Manas-arumalla/Steady-Stride_Self-balancing-robot/steady_stride_v0/Circuits/4] Console Arduino Nano IO-Cmmunications Circuit.pdf

# /pas]a Ground

## Analog

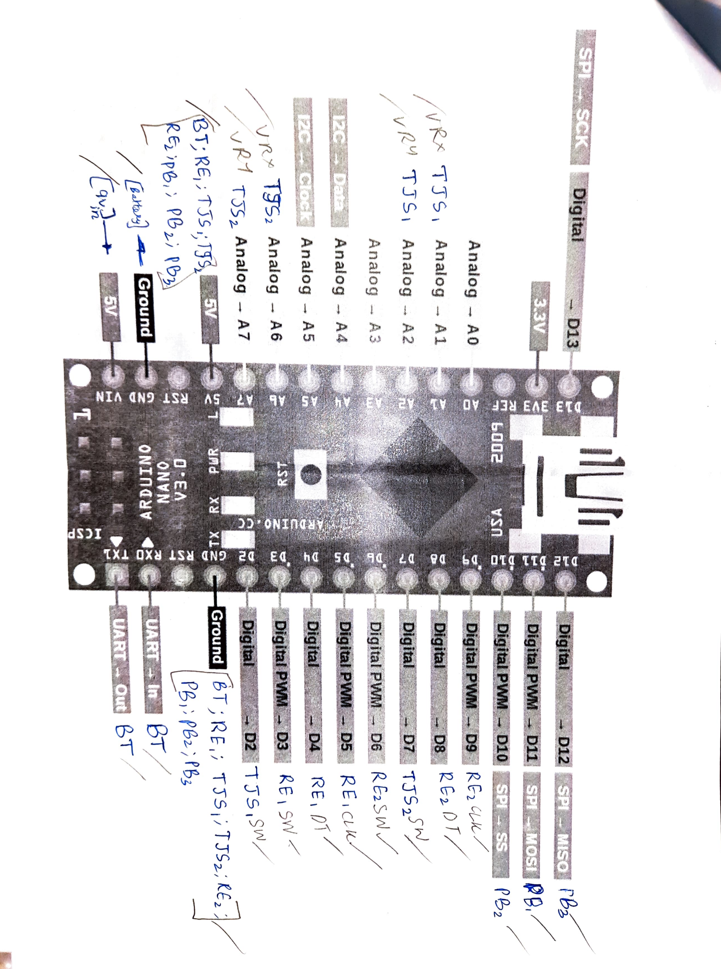
[picture p113: page 1]

ICSP

5V

ONINAN

UART Out BT

ONVN

TJS

### Analog

A7

UART

ARDUINO CC
TX1 RXO RST GND D2

### BT In

Vr

S2

A6

Digital Ground

BT;RE,;

### TSST

JS2,
KE,

### TJS,SW D2

Analog A5 -

A7 AL AS AeA A | AL AD REF 3V3 D13 VIN GND RST | 5V

Digital PWM

D3

## RE, SW

12C Dat

Digital

Analog A4 -

## D4 RE, D1

Digital PWM

Analog A3 -

D5

D3 D4 D5 DE D7 D8 D9 i0 D11 D12

REICLK

Digital PWM

### Analog T3ST /VK

Digital

A1

## RESW TJS,Sh D6 D7

Analog -

Digital

A0

D8

Digital PWM

D9 RE h

Digital PWM D10 Digital PWM D11

F

D13

SCKDigital

P,

Digital

SPI D12

SPIMOSI P

## MISO PB

Analog TJSI

A2
