Manas-arumalla/Steady-Stride_Self-balancing-robot/Gains Calcuation & SImulation/Output Graph.png

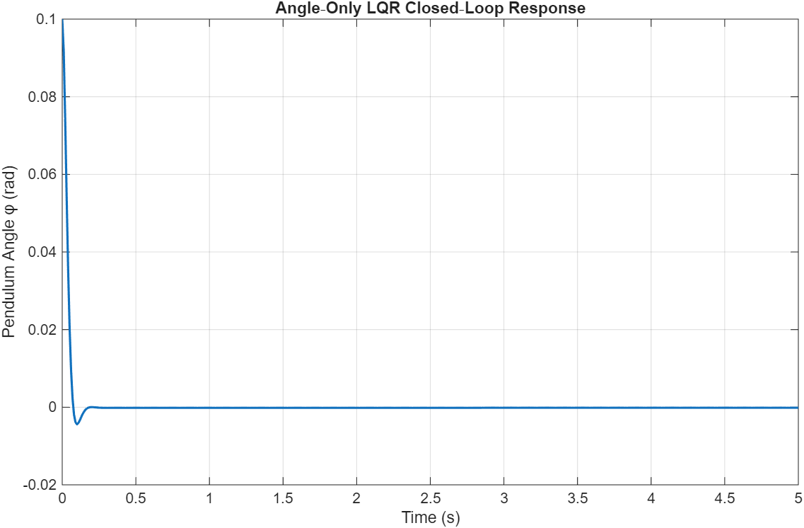
Gains Calcuation & SImulation/Output Graph.png
