Manas-arumalla/Steady-Stride_Self-balancing-robot/steady_stride_v0/Codes/src/libraries_dependencies/FastIMU/fast.png

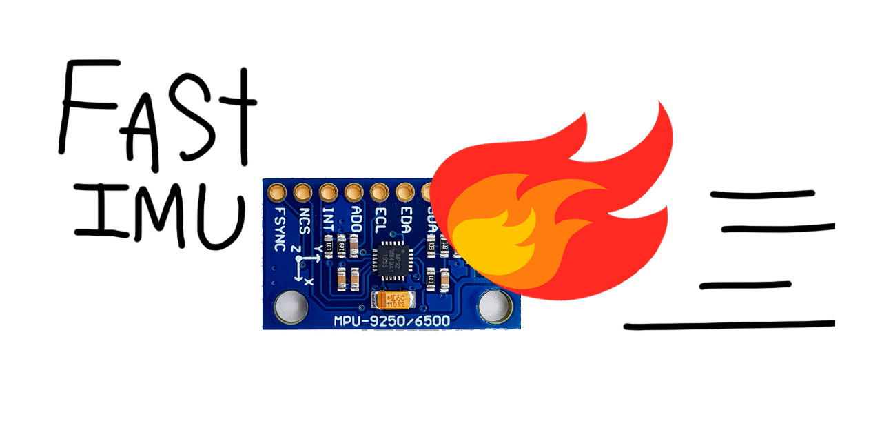
steady_stride_v0/Codes/src/libraries_dependencies/FastIMU/fast.png
