Manas-arumalla/Steady-Stride_Self-balancing-robot/steady_stride_v0/Codes/src/libraries_dependencies/invensense-imu-main/docs/MPU-9250-AXIS.png

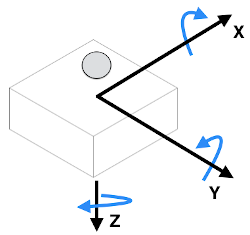
steady_stride_v0/Codes/src/libraries_dependencies/invensense-imu-main/docs/MPU-9250-AXIS.png
