Manas-arumalla/Steady-Stride_Self-balancing-robot/CAD/wheel_shaft_manas.stl

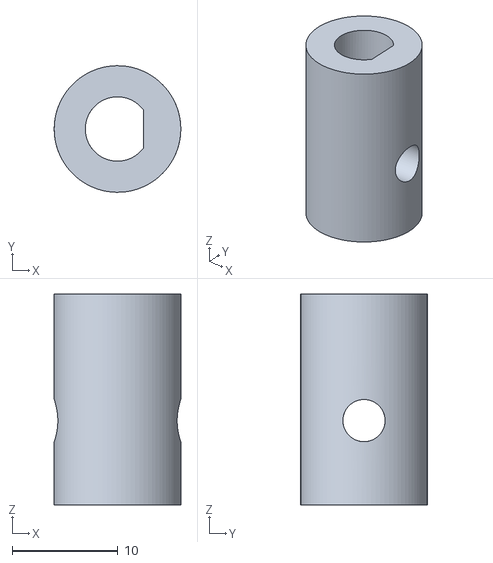
[picture p120: CAD file, 2025-09-05]
CAD/wheel_shaft_manas.stl
12.0 x 12.0 x 20.0
