Manas-arumalla/Steady-Stride_Self-balancing-robot/CAD/Motor_shaft.stl

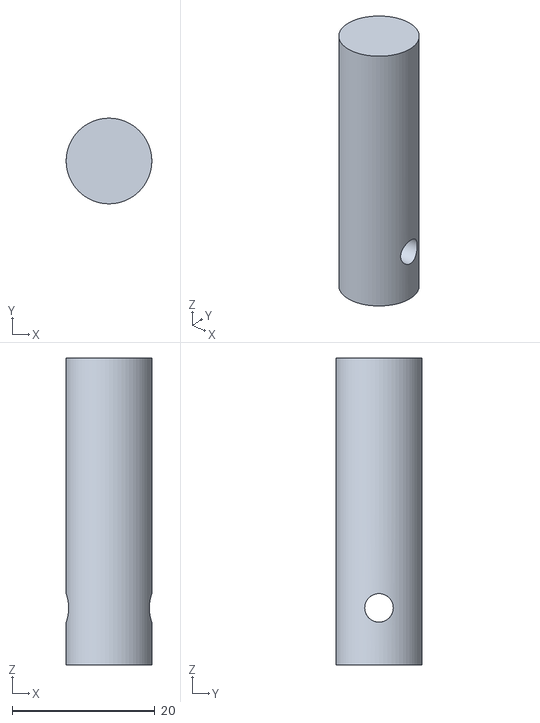
[picture p122: CAD file, 2025-09-05]
CAD/Motor_shaft.stl
12.0 x 12.0 x 43.0
