Manas-arumalla/Steady-Stride_Self-balancing-robot/steady_stride_v0/Codes/src/libraries_dependencies/MPU9250_WE/MPU9250__I2C_Arduino_Wiring.png

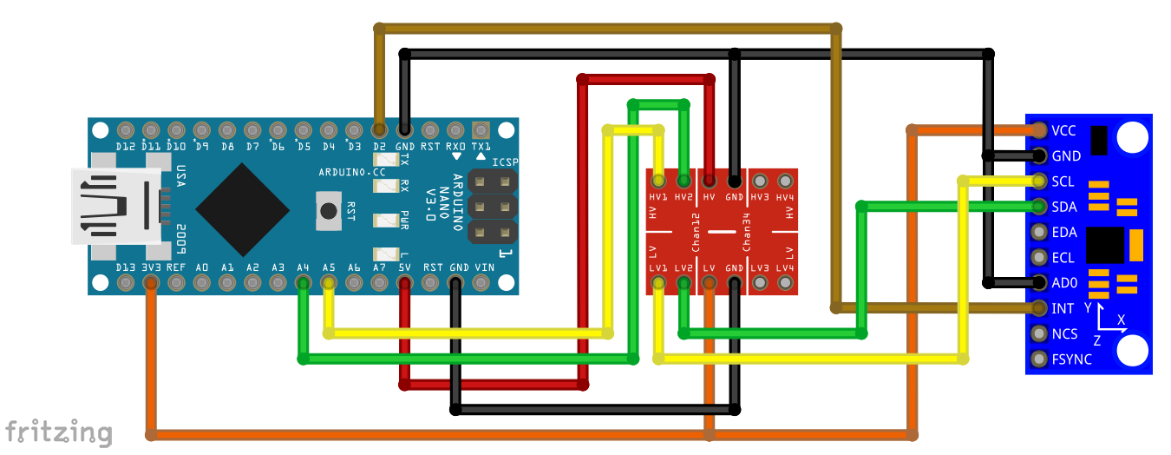
steady_stride_v0/Codes/src/libraries_dependencies/MPU9250_WE/MPU9250__I2C_Arduino_Wiring.png
