Manas-arumalla/Steady-Stride_Self-balancing-robot/Data/TEST1.csv

P:35.00 | I:0.20 | D:-0.40
TIME | gyroAngle
678 | -1.57
702 | -1.49
726 | -1.57
749 | -0.75
773 | -0.25
796 | -0.00
820 | 0.48
843 | 0.90
867 | 1.25
890 | 1.08
913 | 1.19
936 | 1.17
960 | 1.16
984 | 1.15
1007 | 1.21
1031 | 1.04
1054 | 0.99
1078 | 1.03
1101 | 1.11
1125 | 1.12
1148 | 1.13
1172 | 1.19
1196 | 1.22
1218 | 1.25
1242 | 1.33
1265 | 1.30
1289 | 1.39
1312 | 1.39
1336 | 1.51
1359 | 1.78
1383 | 1.86
1406 | 2.09
1430 | 1.99
1454 | 1.80
1477 | 1.11
1501 | 0.28
1524 | -0.46
1548 | -1.37
1571 | -1.99
1595 | -2.40
1618 | -2.03
1642 | -1.65
1666 | 0.01
1692 | 0.88
1715 | 1.88
1736 | 2.71
1759 | 2.59
1781 | 2.16
1804 | 2.10
1825 | 1.67
1848 | 1.20
1870 | 0.71
1893 | -0.09
1915 | -0.62
1937 | -1.22
1959 | -1.69
1982 | -1.92
2004 | -0.93
2027 | 0.08
2049 | 0.74
2071 | 1.38
2094 | 2.00
2116 | 2.71
2138 | 3.05
2160 | 2.96
2183 | 2.51
2204 | 1.38
2227 | 0.29
2249 | -1.03
2272 | -1.70
2294 | -2.83
2316 | -3.61
2338 | -2.84
2361 | -0.95
2383 | 0.55
2405 | 2.02
2427 | 3.52
2450 | 5.17
2472 | 5.17
2495 | 4.68
2516 | 3.61
2539 | 1.76
2562 | -0.85
2584 | -3.51
2606 | -8.11
2628 | -10.14
2651 | -10.41
2673 | -10.14
2700 | -8.53
2721 | -5.28
2744 | -1.89
2766 | 3.37
2789 | 10.43
2811 | 19.25
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
