Manas-arumalla/Steady-Stride_Self-balancing-robot/steady_stride_v0/Documentation/Test Videos - According to S.No in PPT/Photos/Circuit.png

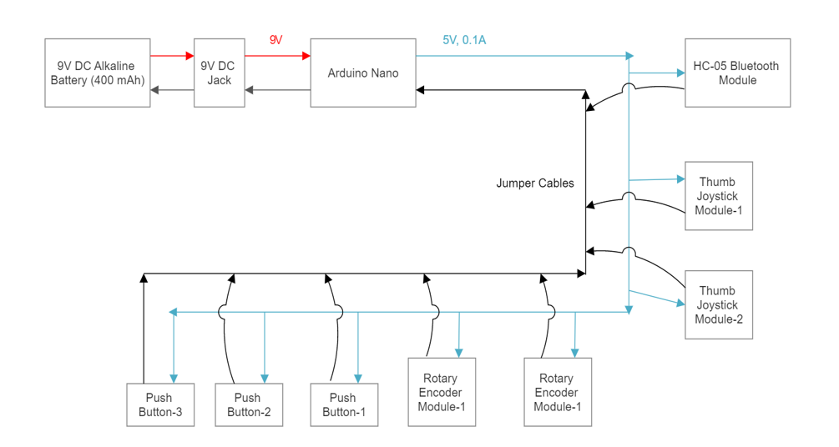
steady_stride_v0/Documentation/Test Videos - According to S.No in PPT/Photos/Circuit.png
