Manas-arumalla/Steady-Stride_Self-balancing-robot/(notices)

Notices in the files:
README.md:
License: MIT
